krmnlhmza/Embedded-nRF24-BT-system/firmware/03-nrf24-dogrudan/flaxKumandaliVerici/flaxKumandaliVerici.ino

// =====================================================================
//  VERICI (KUMANDA)
//  FLAX Bluetooth & NRF24 Kumanda Karti (Nanelab) + Arduino Nano
//  + nRF24L01+PA+LNA (antenli) + 16x2 I2C LCD
//
//  KUTUPHANELER:
//    "RF24"             by TMRh20           (surum 1.4.0 veya ustu)
//    "LiquidCrystal_I2C" by Frank de Brabander  (LCD kullanacaksan)
//
//  SERI PORT : 115200 baud   <-- Serial Monitor'u 115200'e AYARLA
// =====================================================================
//
//  ################  KART PIN HARITASI  ################
//  (kartin uzerindeki baskidan okundu, kullanici dogruladi)
//
//    Joystick A      X -> A0        Y -> A1        buton -> D5
//    Pot                            A3
//    Buton 1         A2             Buton 2  -> D6
//    Buton 3         A7             Buton 4  -> D7
//    Buton 5         A6
//    Buton A         D0             Buton B  -> D1     <-- TEHLIKELI
//    WS2812 RGB LED  D2
//    I2C (J3)        A4 = SDA       A5 = SCL
//    MPU6050         ayni I2C hattinda
//
//  ################  KULLANILAMAYAN PINLER  ################
//
//  D0 / D1 (Buton A ve Buton B):
//    Bunlar Nano'nun DONANIMSAL SERI PORTU. Kod yukleme ve Serial
//    Monitor bu iki pini kullanir. Bu butonlari okumaya kalkarsan:
//      - Serial Monitor'deki tum log'lari kaybedersin
//      - Buton basiliyken kod yukleyemezsin
//      - D1 (TX) cikis surdugu icin butona basmak hatti zorlar
//    Bu yuzden Buton A ve Buton B BU PROJEDE KULLANILMIYOR.
//    Ileride buton lazim olursa: Buton 1 (A2), Buton 2 (D6),
//    Buton 4 (D7) guvenli seciminiz.
//
//  D2 (WS2812 dahili RGB LED):
//    Butona ayirma, LED'in veri hatti orada.
//
//  A6 / A7 (Buton 5 ve Buton 3):
//    Nano'da A6/A7 SADECE ANALOG girdidir. digitalRead() calismaz,
//    dahili pull-up YOKTUR. Bu butonlari kullanacaksan:
//        bool basili = (analogRead(A6) < 500);
//    seklinde esik ile okuman gerekir.
//
//  ################  BESLEME  ################
//    - 18650 pil ile: JP5 jumper TAKILI olmali
//    - 6-9V harici giris ile: JP5 KALDIRILMALI
//    - PIL TERS TAKILIRSA KART KALICI HASAR ALIR
//    - Kod yuklerken Nano'nun KENDI USB'sini kullan
//
//  ################  TELSIZ  ################
//  ADRES, KANAL, VERI_HIZI ve struct tanimlari ALICI ile BIREBIR
//  AYNI olmak ZORUNDA.
//
//  Telemetri (araba -> kumanda) ACK PAYLOAD ile geliyor: araba, gelen
//  her pakete verdigi "aldim" cevabinin icine gerilim ve mesafe
//  bilgisini iliştiriyor. Telsizi yon degistirmeye gerek yok.
// =====================================================================

#include <SPI.h>
#include <RF24.h>

// =====================================================================
//  1) NE KULLANIYORUZ
// =====================================================================

// Kesif modu: 1 yaparsan telsiz ve LCD hic calismaz, sadece tum
// pinlerin anlik degerini basar. Pin dogrulamak icin.
#define PIN_KESIF_MODU   0

// LCD: 16x2 I2C ekran. Kartin J3 konnektorune baglanir.
#define LCD_KULLAN       1

// LCD'nin I2C adresi. Cogu modulde 0x27, bazilarinda 0x3F.
// Hangisi oldugunu bilmiyorsan once I2C tarayici kodunu calistir.
#define LCD_ADRES        0x27

// Butonlar: su an kullanilmiyor. 1 yaparsan Buton 1/2/4 okunur.
#define BUTON_KULLAN     0

// Potansiyometre: 1 yaparsan A3 okunup pakete konur.
#define POT_KULLAN       0

#if LCD_KULLAN
  #include <Wire.h>
  #include <LiquidCrystal_I2C.h>
  LiquidCrystal_I2C lcd(LCD_ADRES, 16, 2);
#endif

// =====================================================================
//  2) PIN TANIMLARI
// =====================================================================

// --- nRF24L01 (kartin kendi soketinde) ---
#define CE_PIN    9
#define CSN_PIN   10
// SPI pinleri sabit: MOSI=D11, MISO=D12, SCK=D13

// --- Joystick A (tek joystick) ---
#define JOY_X_PIN   A0      // sag / sol
#define JOY_Y_PIN   A1      // ileri / geri

// --- Potansiyometre ---
#define POT_PIN     A3

// --- Guvenli butonlar (BUTON_KULLAN 1 ise okunur) ---
#define BUTON_1_PIN   A2    // analog pin ama dijital + pull-up destekler
#define BUTON_2_PIN   6
#define BUTON_4_PIN   7

// A4 = SDA, A5 = SCL -> LCD ve MPU6050. Baska hicbir sey icin kullanma.

// =====================================================================
//  3) TELSIZ AYARLARI  -- ALICI ILE BIREBIR AYNI OLMALI
// =====================================================================

const uint8_t ADRES[6] = "ARB01";
const uint8_t KANAL    = 108;

// DIKKAT: RF24_250KBPS sadece gercek nRF24L01+ cipinde calisir.
// Modul klon cikarsa kod acilista uyaracak; o durumda 1MBPS yap.
#define VERI_HIZI   RF24_250KBPS

// Antenli modulde tam guc. Masada yan yana test edersen alici on kati
// doyar ve paket gitmez; en az 2-3 metre ara birak.
#define RF_GUC      RF24_PA_MAX

// =====================================================================
//  4) SURUS AYARLARI
// =====================================================================

const int SAFE_ZONE = 40;    // merkez olu bolge (-255..255 olceginde)
const unsigned long GONDERIM_ARALIGI = 20;   // ms -> saniyede ~50 paket
const unsigned long LOG_ARALIGI      = 300;  // ms -> seri porta ozet
const unsigned long LCD_ARALIGI      = 250;  // ms -> I2C'yi bogmayalim
const unsigned long LCD_MOD_SURE     = 2000; // ms -> alt satir donusum

// Radar esikleri: ALICI ile ayni olmali (sadece ekranda gostermek icin)
const unsigned int MESAFE_YOK = 999;
const unsigned int DUR_MESAFE = 25;

// =====================================================================
//  5) PAKET YAPILARI  -- ALICI ILE BIREBIR AYNI OLMALI
// =====================================================================

const uint8_t KOMUT_IMZA = 0xA5;
const uint8_t TLM_IMZA   = 0x5A;

// Kumandadan arabaya giden paket (13 bayt)
struct __attribute__((packed)) KomutPaketi {
  uint8_t  imza;        // her zaman 0xA5
  uint8_t  sayac;       // 0..255 dongusel
  uint16_t joyX, joyY;  // HAM ADC 0..1023
  uint16_t pot;         // HAM ADC 0..1023 (kullanilmiyorsa 0)
  uint8_t  butonlar;    // bit maskesi
  int16_t  sol, sag;    // hesaplanmis motor hizlari -255..+255
};
// Motor hizini KUMANDA hesapliyor cunku joystick merkez kalibrasyonu
// burada; araba joystick'in merkezini bilemez. Ham degerler de gidiyor
// ki Serial Monitor'de gorebilelim ve ileride yeni gorev verebilelim.

#define BIT_BUTON1   0x01
#define BIT_BUTON2   0x02
#define BIT_BUTON4   0x04

// Arabadan ACK payload olarak donen telemetri (8 bayt)
struct __attribute__((packed)) TelemetriPaketi {
  uint8_t  imza;      // her zaman 0x5A
  uint16_t vcc;       // arabanin anlik besleme gerilimi (mV)
  uint16_t minVcc;    // arabanin gordugu en dusuk gerilim (mV)
  uint16_t mesafe;    // radar mesafesi (cm), 999 = engel yok
  uint8_t  durum;     // bit0 = engel var
};

#define TLM_BIT_ENGEL  0x01

RF24 radio(CE_PIN, CSN_PIN);

// =====================================================================
//  6) DURUM DEGISKENLERI
// =====================================================================

int merkezX = 512, merkezY = 512;   // acilista olculecek
int olcekX  = 470, olcekY  = 470;

uint8_t sayac = 0;
unsigned long sonGonderim = 0;
unsigned long sonLog      = 0;

unsigned long basarili = 0, basarisiz = 0;
unsigned int  ustusteHata = 0;
bool          uyariBasildi = false;

TelemetriPaketi tlm;
bool tlmGecerli = false;
unsigned long sonTlm = 0;

int sonSol = 0, sonSag = 0;         // ekranda gostermek icin

// LCD durumu
unsigned long sonLcdYazim = 0;
unsigned long sonModDegis = 0;
uint8_t  altMod = 0;                // 0: hizlar   1: gerilimler
bool     gosterilenBagli = false;
unsigned int gosterilenMesafe = 0;
bool     ilkLcdYazim = true;

// =====================================================================
//  7) YARDIMCI FONKSIYONLAR
// =====================================================================

void cizgi() {
  Serial.println(F("---------------------------------------------"));
}

// Ham ADC degerini -255..+255 araligina cevirir (kalibrasyonlu)
int eksenCevir(int ham, int merkez, int olcek) {
  long sapma = (long)ham - (long)merkez;
  long d = sapma * 255L / (long)olcek;
  if (d >  255) d =  255;
  if (d < -255) d = -255;
  return (int)d;
}

// Acilista joystick merkezini olc. JOYSTICK'E DOKUNMA.
void joystickKalibreEt() {
  Serial.println(F("[4/6] Joystick kalibrasyonu... DOKUNMA"));

  // Ilk okumalar ADC multiplexer yuzunden kayabilir, atiyoruz
  for (int i = 0; i < 8; i++) {
    analogRead(JOY_X_PIN); analogRead(JOY_Y_PIN); delay(2);
  }

  long tx = 0, ty = 0;
  int xMin = 1023, xMax = 0, yMin = 1023, yMax = 0;

  for (int i = 0; i < 64; i++) {
    int ax = analogRead(JOY_X_PIN); tx += ax;
    if (ax < xMin) xMin = ax;  if (ax > xMax) xMax = ax;

    int ay = analogRead(JOY_Y_PIN); ty += ay;
    if (ay < yMin) yMin = ay;  if (ay > yMax) yMax = ay;

    delay(3);
  }

  merkezX = tx / 64;
  merkezY = ty / 64;

  Serial.print(F("      Merkez X=")); Serial.print(merkezX);
  Serial.print(F(" Y="));             Serial.print(merkezY);
  Serial.print(F("   Titresim X="));  Serial.print(xMax - xMin);
  Serial.print(F(" Y="));             Serial.println(yMax - yMin);

  bool supheli = false;

  if (merkezX < 300 || merkezX > 724 || merkezY < 300 || merkezY > 724) {
    Serial.println(F("      >> UYARI: merkez 512'den cok uzak."));
    Serial.println(F("         Acilirken joystick'e basiyor olabilirsin."));
    supheli = true;
  }
  if ((xMax - xMin) > 60 || (yMax - yMin) > 60) {
    Serial.println(F("      >> UYARI: okuma gurultulu."));
    supheli = true;
  }

  olcekX = min(merkezX, 1023 - merkezX);
  olcekY = min(merkezY, 1023 - merkezY);
  if (olcekX < 150) { merkezX = 512; olcekX = 470; supheli = true; }
  if (olcekY < 150) { merkezY = 512; olcekY = 470; supheli = true; }

  Serial.println(supheli ? F("      SONUC: joystick SUPHELI")
                         : F("      SONUC: joystick OK"));
}

// Butonlari oku (BUTON_KULLAN 0 iken hep 0 doner)
uint8_t butonlariOku() {
  uint8_t m = 0;
#if BUTON_KULLAN
  if (digitalRead(BUTON_1_PIN) == LOW) m |= BIT_BUTON1;
  if (digitalRead(BUTON_2_PIN) == LOW) m |= BIT_BUTON2;
  if (digitalRead(BUTON_4_PIN) == LOW) m |= BIT_BUTON4;
  // Buton 3 (A7) ve Buton 5 (A6) icin digitalRead CALISMAZ:
  //   if (analogRead(A7) < 500) m |= ...;
#endif
  return m;
}

// --------------------------- LCD ------------------------------------
#if LCD_KULLAN

// Ust satir: baglanti durumu + arabanin onundeki mesafe
//   "BAGLI   M:120cm "   yol acik
//   "BAGLI  !M: 18cm "   unlem = ileri gidis engellendi
//   "KOPUK   M:---cm "   baglanti yok
void lcdUstYaz(bool bagli, unsigned int mes) {
  char buf[17];
  if (!bagli)
    snprintf(buf, sizeof(buf), "KOPUK   M:---cm ");
  else if (mes == 0 || mes >= MESAFE_YOK)
    snprintf(buf, sizeof(buf), "BAGLI   M:---cm ");
  else
    snprintf(buf, sizeof(buf), "BAGLI  %cM:%3ucm ",
             (mes <= DUR_MESAFE) ? '!' : ' ', mes);
  lcd.setCursor(0, 0);
  lcd.print(buf);
}

// Alt satir modu 0: gonderilen motor hizlari
void lcdHizYaz(int sol, int sag) {
  char buf[17];
  snprintf(buf, sizeof(buf), "S:%-6dG:%-6d", sol, sag);
  lcd.setCursor(0, 1);
  lcd.print(buf);
}

// Alt satir modu 1: arabanin anlik ve en dusuk besleme gerilimi
void lcdGerilimYaz(unsigned int vcc, unsigned int mn) {
  char buf[17], v[6], m[6];
  if (vcc >= 2000) snprintf(v, sizeof(v), "%4u", vcc); else strcpy(v, "----");
  if (mn  >= 2000) snprintf(m, sizeof(m), "%4u", mn);  else strcpy(m, "----");
  snprintf(buf, sizeof(buf), "V:%s  MIN:%s", v, m);
  lcd.setCursor(0, 1);
  lcd.print(buf);
}
#endif

// ------------------------- TELSIZ -----------------------------------
void radyoKur() {
  Serial.println(F("[3/6] nRF24L01 baslatiliyor..."));

  if (!radio.begin()) {
    cizgi();
    Serial.println(F("HATA 1: nRF24 modulu hic yanit vermiyor."));
    Serial.println(F("  - Modul kartin soketine TAM oturmus mu?"));
    Serial.println(F("  - Kartin anahtari acik mi, pil dolu mu?"));
    Serial.print  (F("  - CE=")); Serial.print(CE_PIN);
    Serial.print  (F(" CSN=")); Serial.println(CSN_PIN);
    cizgi();
    while (1) delay(1000);
  }

  if (!radio.isChipConnected()) {
    cizgi();
    Serial.println(F("HATA 2: SPI hatti kararsiz, cip okunamiyor."));
    Serial.println(F("  - Modulu cikarip tekrar tak, pili sarj et"));
    cizgi();
    while (1) delay(1000);
  }

  radio.setChannel(KANAL);
  radio.setDataRate(VERI_HIZI);
  radio.setPALevel(RF_GUC);
  radio.setCRCLength(RF24_CRC_16);
  radio.setAutoAck(true);

  radio.enableDynamicPayloads();   // ACK payload icin sart
  radio.enableAckPayload();

  radio.setRetries(5, 15);         // 250KBPS'te 1500us bekle, 15 kez dene

  if (radio.getChannel() != KANAL) {
    cizgi();
    Serial.println(F("HATA 3: Ayarlar module yazilamiyor."));
    Serial.println(F("  Besleme yetersiz. Pili sarj et, JP5'i kontrol et."));
    cizgi();
    while (1) delay(1000);
  }

  radio.openWritingPipe(ADRES);
  radio.stopListening();           // biz gondericiyiz (PTX)

  Serial.println(F("      SONUC: telsiz OK"));
}

void radyoBilgisiYaz() {
  cizgi();
  Serial.println(F("TELSIZ AYARLARI (alici ile AYNI olmali):"));
  Serial.print(F("  Kanal        : ")); Serial.println(radio.getChannel());
  Serial.print(F("  Veri hizi    : "));
  switch (radio.getDataRate()) {
    case RF24_250KBPS: Serial.println(F("250KBPS")); break;
    case RF24_1MBPS:   Serial.println(F("1MBPS"));   break;
    case RF24_2MBPS:   Serial.println(F("2MBPS"));   break;
  }
  Serial.print(F("  RF gucu      : "));
  switch (radio.getPALevel()) {
    case RF24_PA_MIN:  Serial.println(F("MIN"));  break;
    case RF24_PA_LOW:  Serial.println(F("LOW"));  break;
    case RF24_PA_HIGH: Serial.println(F("HIGH")); break;
    case RF24_PA_MAX:  Serial.println(F("MAX"));  break;
  }
  Serial.print(F("  Adres        : ")); Serial.println((const char*)ADRES);
  Serial.print(F("  Komut paketi : ")); Serial.print(sizeof(KomutPaketi));
  Serial.println(F(" bayt"));
  Serial.print(F("  Telemetri    : ")); Serial.print(sizeof(TelemetriPaketi));
  Serial.println(F(" bayt"));
  Serial.print(F("  Modul tipi   : "));
  if (radio.isPVariant()) {
    Serial.println(F("nRF24L01+ (gercek)"));
  } else {
    Serial.println(F("nRF24L01 veya KLON"));
    Serial.println(F("  >> !! Bu modulde RF24_250KBPS CALISMAZ !!"));
    Serial.println(F("  >> VERI_HIZI'ni RF24_1MBPS yap (iki tarafta da)."));
  }
  cizgi();
}

// ---------------------- PIN KESIF MODU ------------------------------
#if PIN_KESIF_MODU
void kesifYaz() {
  Serial.print(F("A0="));   Serial.print(analogRead(A0));
  Serial.print(F(" A1="));  Serial.print(analogRead(A1));
  Serial.print(F(" A2="));  Serial.print(analogRead(A2));
  Serial.print(F(" A3="));  Serial.print(analogRead(A3));
  Serial.print(F(" A6="));  Serial.print(analogRead(A6));
  Serial.print(F(" A7="));  Serial.print(analogRead(A7));
  Serial.print(F("  | D5=")); Serial.print(digitalRead(5));
  Serial.print(F(" D6="));    Serial.print(digitalRead(6));
  Serial.print(F(" D7="));    Serial.println(digitalRead(7));
  // A4/A5 okunmuyor: I2C hatti, okumak ekranin isini bozar.
  // D0/D1 okunmuyor: seri port.
}
#endif

// =====================================================================
//  8) SETUP
// =====================================================================
void setup() {
  Serial.begin(115200);
  while (!Serial && millis() < 2000) { }

  delay(300);
  cizgi();
  Serial.println(F("  VERICI : FLAX KUMANDA + nRF24 + LCD"));
  Serial.println(F("  Serial Monitor 115200 baud olmali"));
  cizgi();
  Serial.println(F("[1/6] Kart uyandi."));

#if BUTON_KULLAN
  pinMode(BUTON_1_PIN, INPUT_PULLUP);
  pinMode(BUTON_2_PIN, INPUT_PULLUP);
  pinMode(BUTON_4_PIN, INPUT_PULLUP);
  Serial.println(F("      Butonlar acik (Buton 1/2/4)."));
#else
  Serial.println(F("      Butonlar kapali (BUTON_KULLAN 0)."));
#endif

#if PIN_KESIF_MODU
  pinMode(5, INPUT_PULLUP);
  pinMode(6, INPUT_PULLUP);
  pinMode(7, INPUT_PULLUP);
  cizgi();
  Serial.println(F("  PIN KESIF MODU ACIK -> telsiz ve LCD calismiyor."));
  Serial.println(F("  Joystick'i oynat, degisen kanali gor."));
  Serial.println(F("  Bittiginde PIN_KESIF_MODU'nu 0 yap."));
  cizgi();
  return;
#endif

  // --- LCD ---
#if LCD_KULLAN
  Serial.println(F("[2/6] LCD baslatiliyor..."));
  Wire.begin();
  lcd.init();
  lcd.backlight();
  lcd.clear();
  lcd.setCursor(0, 0);
  lcd.print("KALIBRASYON...  ");
  lcd.setCursor(0, 1);
  lcd.print("JOYSTICK SERBEST");

  // Ekranda hicbir sey cikmiyorsa adres yanlis olabilir.
  Wire.beginTransmission(LCD_ADRES);
  if (Wire.endTransmission() == 0) {
    Serial.print(F("      LCD 0x"));
    Serial.print(LCD_ADRES, HEX);
    Serial.println(F(" adresinde bulundu."));
  } else {
    Serial.print(F("      >> UYARI: 0x"));
    Serial.print(LCD_ADRES, HEX);
    Serial.println(F(" adresinde cevap yok."));
    Serial.println(F("         LCD_ADRES'i 0x3F yapip dene."));
    Serial.println(F("         Ya da SDA/SCL kablolari ters/temassiz."));
  }
#else
  Serial.println(F("[2/6] LCD kapali (LCD_KULLAN 0)."));
#endif

  radyoKur();
  radyoBilgisiYaz();
  joystickKalibreEt();

#if LCD_KULLAN
  lcd.clear();
  lcdUstYaz(false, MESAFE_YOK);
  lcdHizYaz(0, 0);
  gosterilenBagli  = false;
  gosterilenMesafe = MESAFE_YOK;
  sonModDegis = millis();
#endif

  Serial.println(F("[5/6] Arabayi ac ve bekle..."));
  Serial.println(F("[6/6] Hazir."));
  cizgi();
  Serial.println(F("SATIR FORMATI:"));
  Serial.println(F("  ham   -> joystick ADC degerleri (0..1023)"));
  Serial.println(F("  sol/sag -> gonderilen motor hizlari"));
  Serial.println(F("  ACK   -> arabadan cevap geldi mi, % basari orani"));
  Serial.println(F("  V/MIN -> arabanin anlik / en dusuk gerilimi (mV)"));
  Serial.println(F("  M     -> arabanin onundeki mesafe (cm)"));
  cizgi();
}

// =====================================================================
//  9) LOOP
// =====================================================================
void loop() {

#if PIN_KESIF_MODU
  static unsigned long sonKesif = 0;
  if (millis() - sonKesif >= 250) { sonKesif = millis(); kesifYaz(); }
  return;
#endif

  unsigned long simdi = millis();

  // =============== A) 20 ms'de bir paket gonder ===============
  if (simdi - sonGonderim >= GONDERIM_ARALIGI) {
    sonGonderim = simdi;

    KomutPaketi p;
    p.imza  = KOMUT_IMZA;
    p.sayac = sayac++;

    // --- 1) Joystick'i oku (HAM) ---
    p.joyX = (uint16_t)analogRead(JOY_X_PIN);
    p.joyY = (uint16_t)analogRead(JOY_Y_PIN);

#if POT_KULLAN
    p.pot = (uint16_t)analogRead(POT_PIN);
#else
    p.pot = 0;
#endif

    p.butonlar = butonlariOku();

    // --- 2) -255..+255 olcegine cevir ---
    int ileri = eksenCevir(p.joyY, merkezY, olcekY);   // + ileri, - geri
    int donus = eksenCevir(p.joyX, merkezX, olcekX);   // + sag,   - sol

    // Merkezdeki titremeyi 0 say, yoksa araba kendi kendine kimildar
    if (abs(ileri) < SAFE_ZONE) ileri = 0;
    if (abs(donus) < SAFE_ZONE) donus = 0;

    // --- 3) Diferansiyel karisim (eski kodla ayni mantik) ---
    int sol = 0, sag = 0;

    if (ileri == 0 && donus == 0) {
      sol = 0; sag = 0;                         // ortada: dur
    } else if (ileri == 0) {
      sol =  donus;                             // yerinde donus
      sag = -donus;
    } else if (ileri > 0) {
      sol = constrain(ileri + donus, 0, 255);   // ileri
      sag = constrain(ileri - donus, 0, 255);
    } else {
      sol = constrain(ileri + donus, -255, 0);  // geri
      sag = constrain(ileri - donus, -255, 0);
    }

    p.sol = (int16_t)sol;
    p.sag = (int16_t)sag;
    sonSol = sol;  sonSag = sag;

    // --- 4) Gonder ---
    bool ok = radio.write(&p, sizeof(p));

    if (ok) {
      basarili++;
      ustusteHata = 0;
      uyariBasildi = false;

      // ACK'in icinde telemetri var mi?
      while (radio.isAckPayloadAvailable()) {
        uint8_t boy = radio.getDynamicPayloadSize();
        if (boy == sizeof(TelemetriPaketi)) {
          TelemetriPaketi gelen;
          radio.read(&gelen, sizeof(gelen));
          if (gelen.imza == TLM_IMZA) {
            tlm = gelen;
            tlmGecerli = true;
            sonTlm = simdi;
          }
        } else {
          uint8_t cop[32];
          radio.read(cop, (boy > 32) ? 32 : boy);
        }
      }
    } else {
      basarisiz++;
      ustusteHata++;
    }

    // Telemetri bayatladiysa ekranda asili kalmasin
    if (tlmGecerli && (simdi - sonTlm > 1000)) tlmGecerli = false;

    // --- 5) Seri porta ozet ---
    if (simdi - sonLog >= LOG_ARALIGI) {
      sonLog = simdi;

      Serial.print(F("ham "));    Serial.print(p.joyX);
      Serial.print(F(","));       Serial.print(p.joyY);
#if POT_KULLAN
      Serial.print(F(" pot="));   Serial.print(p.pot);
#endif
      Serial.print(F(" | sol=")); Serial.print(p.sol);
      Serial.print(F(" sag="));   Serial.print(p.sag);
#if BUTON_KULLAN
      Serial.print(F(" | B1="));  Serial.print((p.butonlar & BIT_BUTON1) ? 1 : 0);
      Serial.print(F(" B2="));    Serial.print((p.butonlar & BIT_BUTON2) ? 1 : 0);
      Serial.print(F(" B4="));    Serial.print((p.butonlar & BIT_BUTON4) ? 1 : 0);
#endif
      Serial.print(ok ? F(" | ACK") : F(" | --- "));

      unsigned long toplam = basarili + basarisiz;
      if (toplam > 0) {
        Serial.print(F(" %"));
        Serial.print((basarili * 100UL) / toplam);
      }

      if (tlmGecerli) {
        Serial.print(F(" | V="));  Serial.print(tlm.vcc);
        Serial.print(F(" MIN="));  Serial.print(tlm.minVcc);
        Serial.print(F(" M="));
        if (tlm.mesafe >= MESAFE_YOK) Serial.print(F("---"));
        else                          Serial.print(tlm.mesafe);
        if (tlm.durum & TLM_BIT_ENGEL) Serial.print(F("!"));
      } else {
        Serial.print(F(" | telemetri YOK"));
      }
      Serial.println();
    }

    // --- 6) Baglanti hic kurulamiyorsa ---
    if (ustusteHata == 50 && !uyariBasildi) {
      uyariBasildi = true;
      cizgi();
      Serial.println(F("!! 1 SANIYEDIR HIC ACK GELMIYOR."));
      Serial.println(F("   1) Araba acik mi, alici kodu yuklu mu?"));
      Serial.println(F("   2) KANAL iki tarafta da 108 mi?"));
      Serial.println(F("   3) VERI_HIZI iki tarafta ayni mi?"));
      Serial.println(F("   4) ADRES iki tarafta ARB01 mi?"));
      Serial.println(F("   5) struct KomutPaketi iki tarafta ayni mi?"));
      Serial.println(F("   6) PA_MAX'ta cok yakinsan anten doyar -> uzaklas."));
      Serial.println(F("   7) 3.3V besleme saglam mi?"));
      cizgi();
    }
  }

  // =============== B) LCD guncelle (I2C yavas, ayri zamanla) =========
#if LCD_KULLAN
  if (simdi - sonLcdYazim >= LCD_ARALIGI) {
    sonLcdYazim = simdi;

    unsigned int mes = tlmGecerli ? tlm.mesafe : MESAFE_YOK;

    // Ust satir: sadece degistiginde yaz, I2C bogulmasin
    if (ilkLcdYazim || tlmGecerli != gosterilenBagli || mes != gosterilenMesafe) {
      lcdUstYaz(tlmGecerli, mes);
      gosterilenBagli  = tlmGecerli;
      gosterilenMesafe = mes;
    }

    // Alt satir: 2 saniyede bir hizlar <-> gerilimler
    if (simdi - sonModDegis >= LCD_MOD_SURE) {
      sonModDegis = simdi;
      altMod = 1 - altMod;
    }

    if (altMod == 0) lcdHizYaz(sonSol, sonSag);
    else             lcdGerilimYaz(tlmGecerli ? tlm.vcc : 0,
                                   tlmGecerli ? tlm.minVcc : 0);

    ilkLcdYazim = false;
  }
#endif
}
